jfen999/pico-dc-motor-controller/DC_Motor_Controller_Carrier.kicad_pcb

## KiCad design Hardware/ControlBoard/mcu.kicad_sch

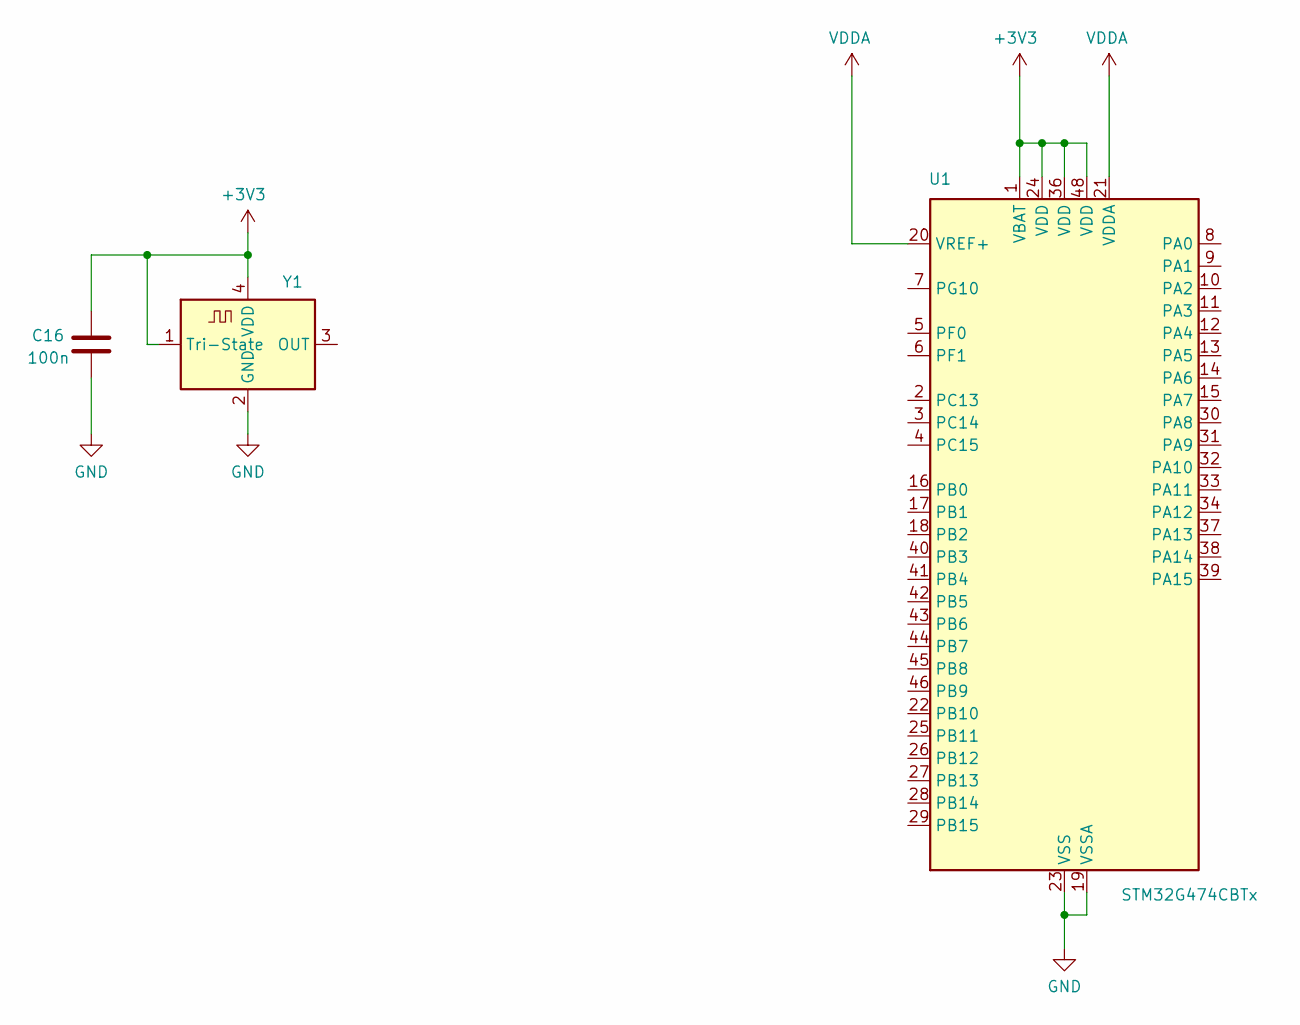
[picture p1: schematic mcu.kicad_sch]

Parts:
C16: 100n
U1: STM32G474CBTx; LQFP-48_7x7mm_P0.5mm
Y1: ECS-2520MV-xxx-xx; Oscillator_SMD_ECS_2520MV-xxx-xx-4Pin_2.5x2.0mm

Connections:
+3V3: C16.1, U1.1 (VBAT), U1.24 (VDD), U1.36 (VDD), U1.48 (VDD), Y1.1 (Tri-State), Y1.4 (VDD)
GND: C16.2, U1.19 (VSSA), U1.23 (VSS), U1.35 (VSS), U1.47 (VSS), Y1.2 (GND)
VDDA: U1.20 (VREF+), U1.21 (VDDA)
