jfen999/pico-dc-motor-controller/DC_Motor_Controller_Carrier.kicad_pcb

## KiCad design Hardware/ControlBoard/power.kicad_sch

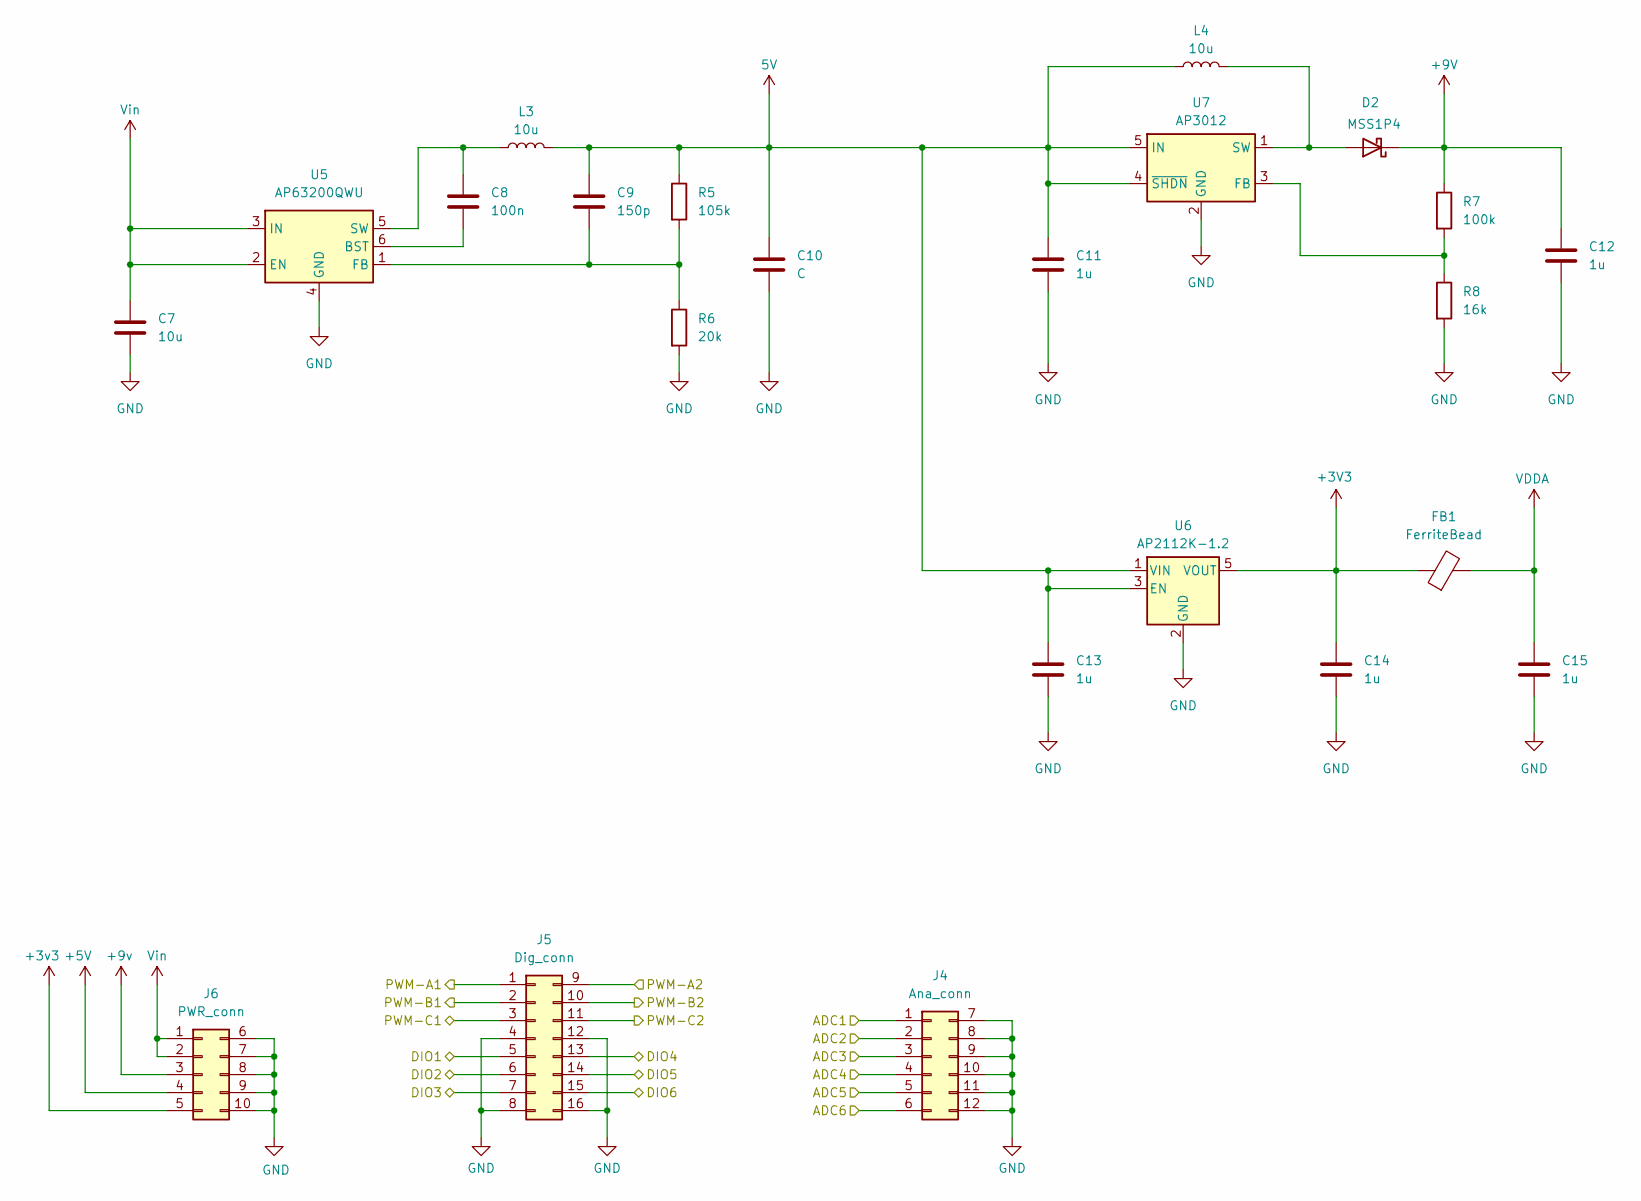
[picture p2: schematic power.kicad_sch]

Parts:
C7: 10u
C8: 100n
C9: 150p
C10: C
C11, C12, C13, C14, C15: 1u
D2: MSS1P4
FB1: FerriteBead
J4: Ana_conn
J5: Dig_conn
J6: PWR_conn
L3, L4: 10u
R5: 105k
R6: 20k
R7: 100k
R8: 16k
U5: AP63200QWU; TSOT-23-6
U6: AP2112K-1.2; SOT-23-5
U7: AP3012; SOT-23-5

Connections:
5V: C9.1, C10.1, C11.1, C13.1, L3.2, L4.1, R5.1, U6.1 (VIN), U6.3 (EN), U7.4 (~SHDN), U7.5 (IN)
+3V3: C14.1, FB1.1, J6.5, U6.5 (VOUT)
+5V: J6.4
+9V: C12.1, D2.1 (K), J6.3, R7.1
ADC1: J4.1
ADC2: J4.2
ADC3: J4.3
ADC4: J4.4
ADC5: J4.5
ADC6: J4.6
DIO1: J5.5
DIO2: J5.6
DIO3: J5.7
DIO4: J5.13
DIO5: J5.14
DIO6: J5.15
GND: C7.2, C10.2, C11.2, C12.2, C13.2, C14.2, C15.2, J4.7, J4.8, J4.9, J4.10, J4.11, J4.12, J5.4, J5.8, J5.12, J5.16, J6.6, J6.7, J6.8, J6.9, J6.10, R6.2, R8.2, U5.4 (GND), U6.2 (GND), U7.2 (GND)
unnamed: C8.1, L3.1, U5.5 (SW)
unnamed: C8.2, U5.6 (BST)
unnamed: C9.2, R5.2, R6.1, U5.1 (FB)
unnamed: D2.2 (A), L4.2, U7.1 (SW)
unnamed: R7.2, R8.1, U7.3 (FB)
PWM-A1: J5.1
PWM-A2: J5.9
PWM-B1: J5.2
PWM-B2: J5.10
PWM-C1: J5.3
PWM-C2: J5.11
VDDA: C15.1, FB1.2
Vin: C7.1, J6.1, J6.2, U5.2 (EN), U5.3 (IN)
